clacktronics/EuroClack_mini_speaker_MKII/EuroClack_Mini_speaker_MKII_panel/panel.pdf

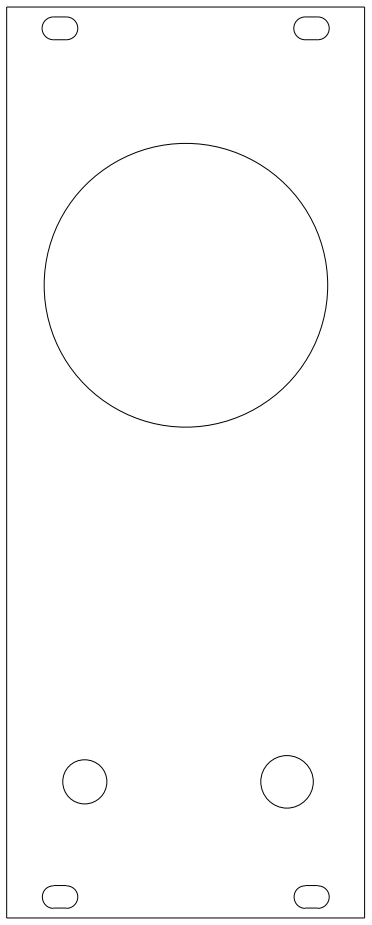
[picture p1: figure]
