clacktronics/EuroClack_mini_speaker_MKII/Rail_adaptor/jlcpcb/production_files/BOM-Rail_adaptor.csv

Comment | Designator | Footprint | LCSC
EURO_PLUG | J1 | PinSocket_2x08_P2.54mm_Vertical_SMD | C30734
