clacktronics/EuroClack_mini_speaker_MKII/main_board/main_board.step

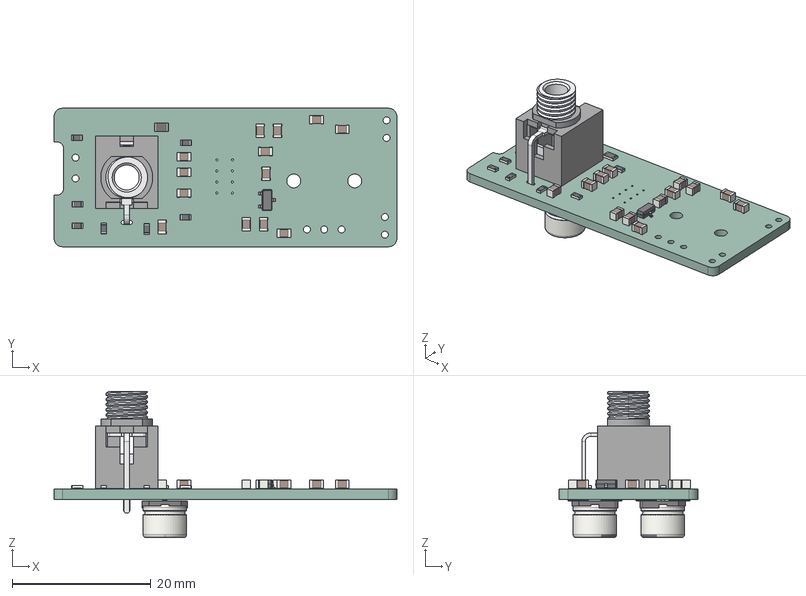
[picture p2: CAD file, 2026-09-18]
main_board/main_board.step
49.5 x 20.0 x 21.1 mm
R_0805_2012Metric
C_0805_2012Metric x 13
R_0603_1608Metric x 7
T
R
Hole
S
SOT-23-3
CP_Elec_6.3x5.4 x 2
main_board_PCB
