clacktronics/EuroClack_mini_speaker_MKII/EuroClack_Mini_speaker_MKII_panel/EuroClack_Mini_speaker_MKII_panel.step

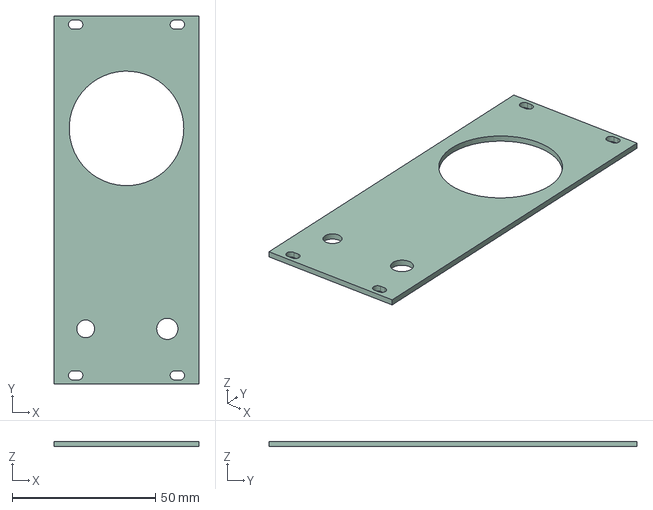
[picture p3: CAD file, 2026-09-18]
EuroClack_Mini_speaker_MKII_panel/EuroClack_Mini_speaker_MKII_panel.step
50.5 x 128.5 x 1.91 mm
