clacktronics/EuroClack_mini_speaker_MKII/EuroClack_Mini_speaker_MKII_panel/demo_panel_1.stl

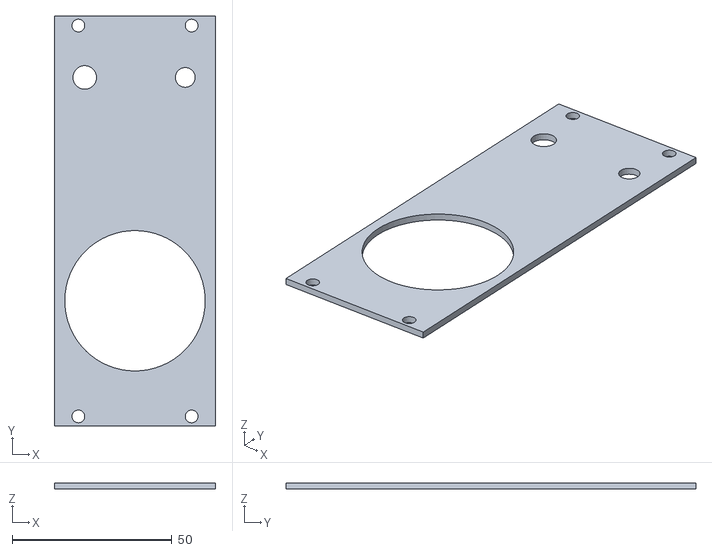
[picture p4: CAD file, 2026-09-18]
EuroClack_Mini_speaker_MKII_panel/demo_panel_1.stl
50.5 x 128.5 x 2.00
