clacktronics/EuroClack_mini_speaker_MKII/EuroClack_Mini_speaker_MKII_panel/#EuroClack_Mini_speaker_MKII_panel-Edge_Cuts.dxf

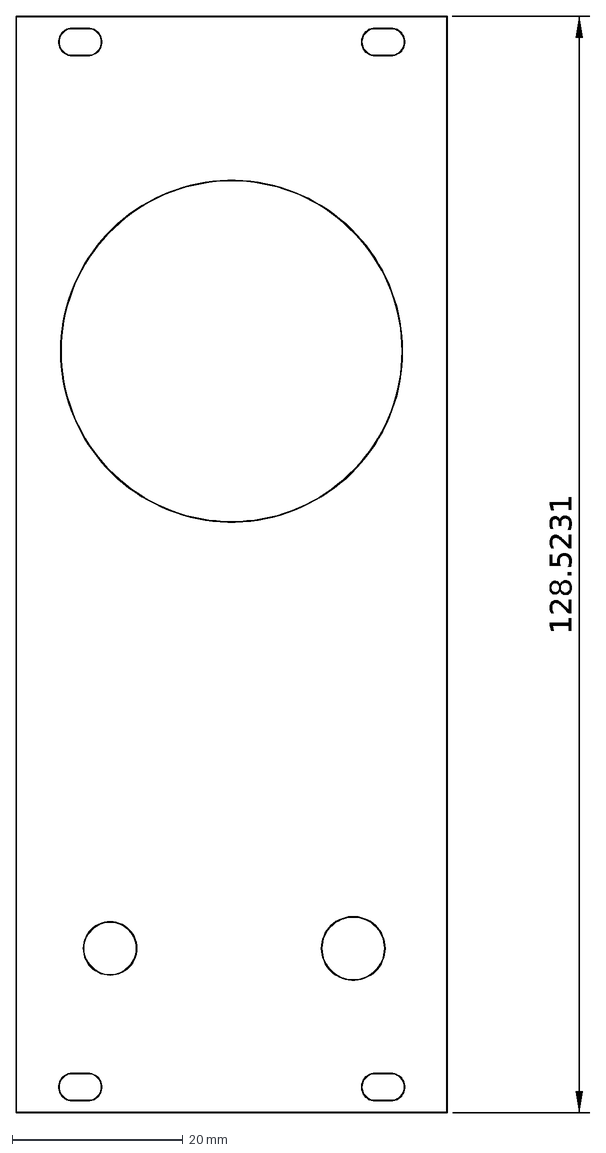
[picture p5: CAD file, 2026-09-18]
EuroClack_Mini_speaker_MKII_panel/#EuroClack_Mini_speaker_MKII_panel-Edge_Cuts.dxf
128.5231
