clacktronics/EuroClack_mini_speaker_MKII/(list of files, cad)

Other CAD files:
EuroClack_Mini_speaker_MKII_panel/EuroClack_Mini_speaker_MKII_panel-Edge_Cuts.dxf
