clacktronics/EuroClack_mini_speaker_MKII/EuroClack_Mini_speaker_MKII_panel/clacktronics_panel_colours.pdf

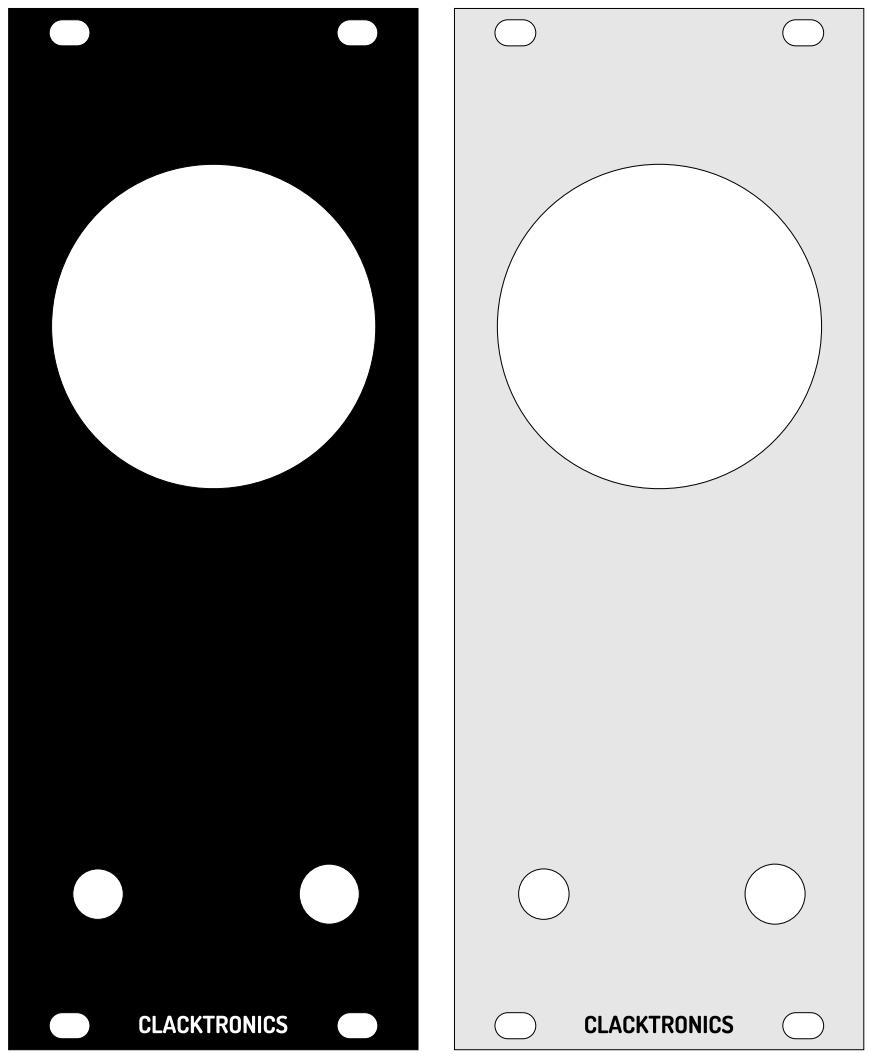
[picture p6: page 1]
