clacktronics/EuroClack_mini_speaker_MKII/EuroClack_Mini_speaker_MKII_panel/panel_graphics.pdf

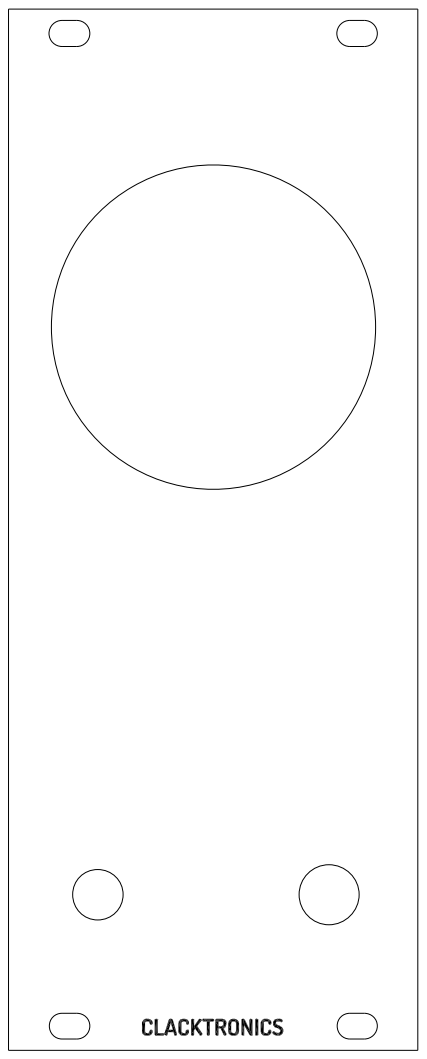
[picture p7: page 1]
