clacktronics/EuroClack_mini_speaker_MKII/EuroClack_Mini_speaker_MKII_panel/panel_measuerments.pdf

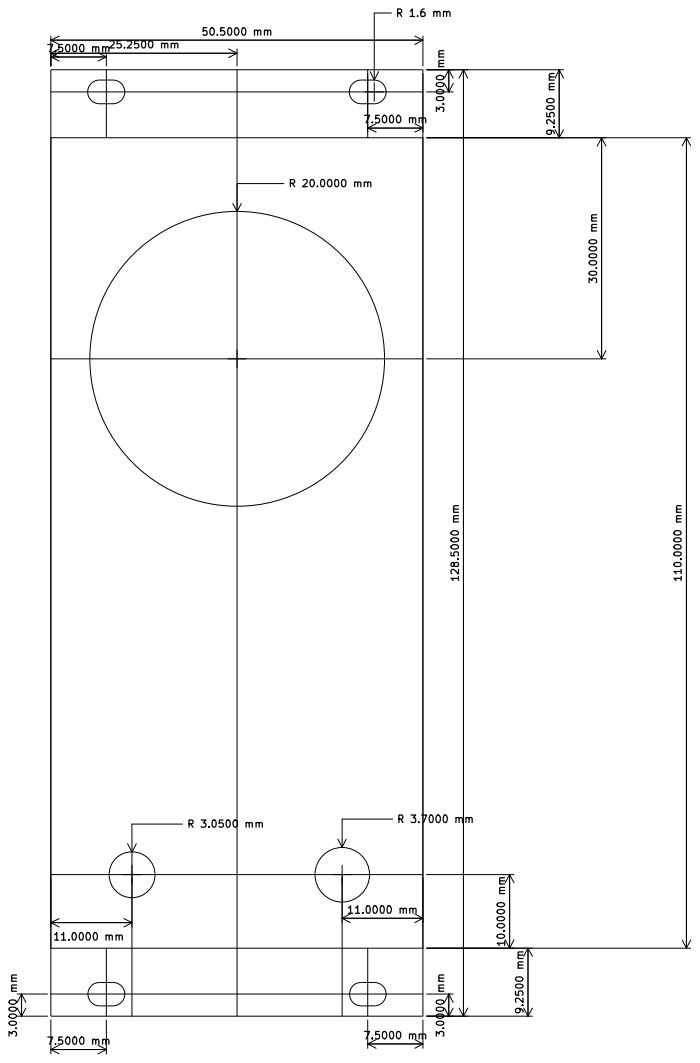
[picture p8: page 1]
