clacktronics/EuroClack_mini_speaker_MKII/main_board/main_board.kicad_pcb

## KiCad design main_board/main_board.kicad_pcb (2026-09-18)

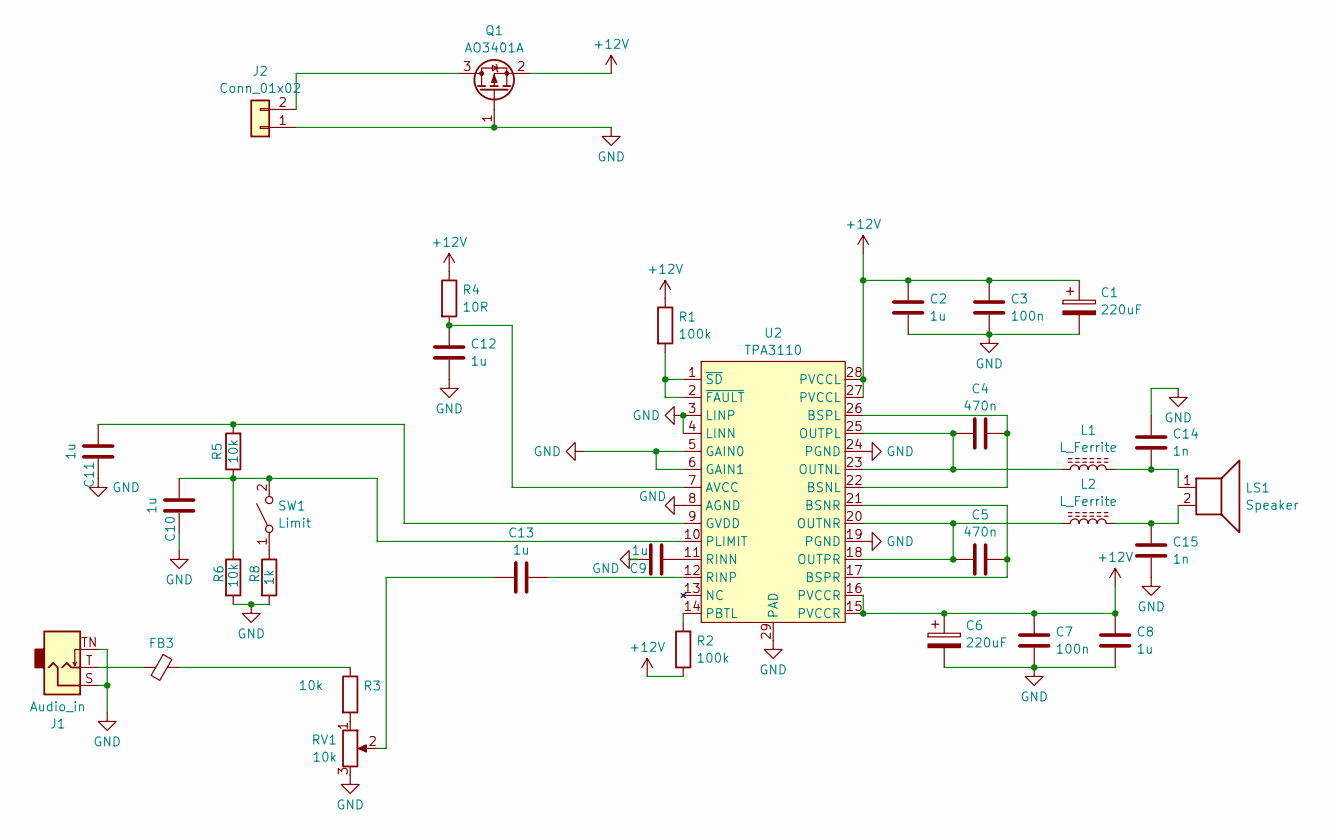
[picture p9: schematic main_board.kicad_sch]

Parts:
C1, C6: 220uF; CP_Elec_6.3x5.4; LCSC C2977551
C2, C8, C9, C10, C11, C12, C13: 1u; C_0805_2012Metric; LCSC C28323
C3, C7: 100n; C_0805_2012Metric; LCSC C28233
C4, C5: 470n; C_0805_2012Metric; LCSC C13967
C14, C15: 1n; C_0805_2012Metric; LCSC C46653
FB3: FerriteBead_Small; R_0603_1608Metric; LCSC C1002
J1: Audio_in; Jack_3.5mm_QingPu_WQP-PJ398SM_Vertical
J2: Conn_01x02; PinHeader_1x02_P2.54mm_Vertical
L1, L2: L_Ferrite; IND-SMD_L7.5-W7.5; LCSC C58313
LS1: Speaker; PinHeader_1x02_P2.54mm_Vertical
Q1: AO3401A; SOT-23-3; LCSC C15127
R1, R2: 100k; R_0603_1608Metric; LCSC C25803
R3, R5, R6: 10k; R_0603_1608Metric; LCSC C25804
R4: 10R; R_0805_2012Metric; LCSC C17415
R8: 1k; R_0603_1608Metric; LCSC C21190
RV1: 10k; POT_TH_Alps_RK09K_Single_Vertical
SW1: Limit; SW-SMD_SK-3293S; LCSC C466006
U2: TPA3110; HTSSOP-28-1EP_4.4x9.7mm_P0.65mm_EP2.85x5.4mm_ThermalVias; LCSC C30132

Connections:
+12V: C1.1, C2.1, C3.1, C6.1, C7.1, C8.1, Q1.2 (S), R1.1, R2.1, R4.1, U2.15 (PVCCR), U2.16 (PVCCR), U2.27 (PVCCL), U2.28 (PVCCL)
GND: C1.2, C2.2, C3.2, C6.2, C7.2, C8.2, C9.1, C10.1, C11.1, C12.1, C14.1, C15.2, J1.S, J1.TN, J2.1, Q1.1 (G), R6.2, R8.2, RV1.3, U2.3 (LINP), U2.4 (LINN), U2.5 (GAIN0), U2.6 (GAIN1), U2.8 (AGND), U2.19 (PGND), U2.24 (PGND), U2.29 (PAD)
unnamed: C13.2, RV1.2
unnamed: C14.2, L1.2, LS1.1
unnamed: C15.1, L2.2, LS1.2
unnamed: FB3.1, R3.1
unnamed: FB3.2, J1.T
unnamed: J2.2, Q1.3 (D)
unnamed: R3.2, RV1.1
unnamed: R8.1, SW1.1 (A)
unnamed: C10.2, R5.1, R6.1, SW1.2 (B), U2.10 (PLIMIT)
unnamed: C12.2, R4.2, U2.7 (AVCC)
unnamed: C4.2, U2.22 (BSNL), U2.26 (BSPL)
unnamed: C5.2, U2.17 (BSPR), U2.21 (BSNR)
unnamed: C11.2, R5.2, U2.9 (GVDD)
unnamed: C4.1, L1.1, U2.23 (OUTNL), U2.25 (OUTPL)
unnamed: C5.1, L2.1, U2.18 (OUTPR), U2.20 (OUTNR)
unnamed: R2.2, U2.14 (PBTL)
unnamed: C9.2, U2.11 (RINN)
unnamed: C13.1, U2.12 (RINP)
unnamed: R1.2, U2.1 (~SD), U2.2 (~FAULT)

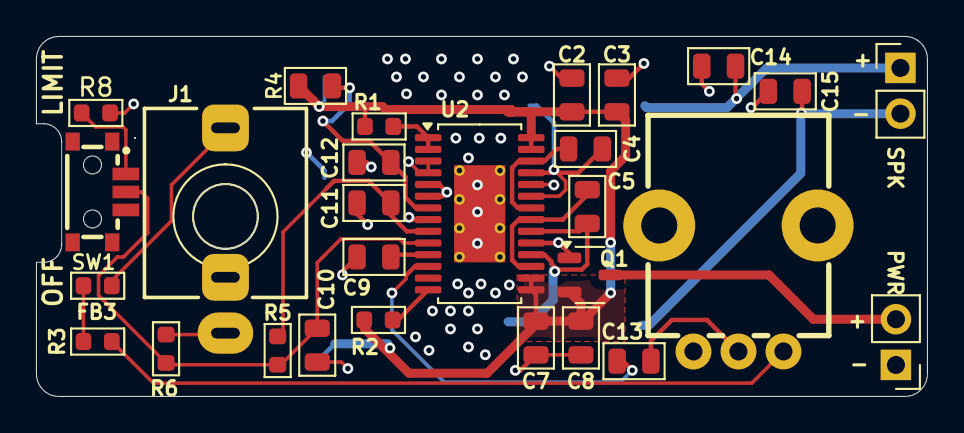
[picture p10: board main_board.kicad_pcb from above]

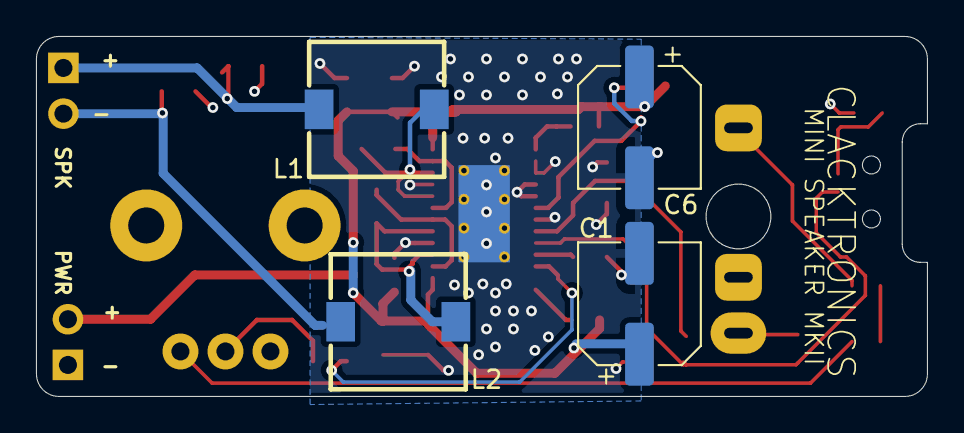
[picture p11: board main_board.kicad_pcb from below]

Board: 4 copper layers, 49.5 x 20.0 mm, 32 parts (4 on the bottom side), 21 nets.
