clacktronics/EuroClack_mini_speaker_MKII/(commit log)

2026-09-18 initial files
    [#EuroClack_Mini_speaker_MKII_panel-Edge_Cuts.dxf, BOM-EuroClack_Mini_speaker_MKII_panel.csv, BOM-Rail_adaptor.csv, BOM-main_board.csv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]
2026-09-23 Add in-depth design review (kicad-happy analysis)
    Claude-Session: https://claude.ai/code/session_01Aw9jveNAjwUBE85KAmxFAz
2026-09-23 Design review: add Eurorack vs external-12V power mode analysis
    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
2026-09-26 Design review: basic-parts-only fixes for Q1 and power path
    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
2026-09-26 Design review: update power section for single DC-jack architecture
    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
